barrystaes/Stoommachine-Aircontrol/2017 nette versie/schemas/Print aircontroller.jpg

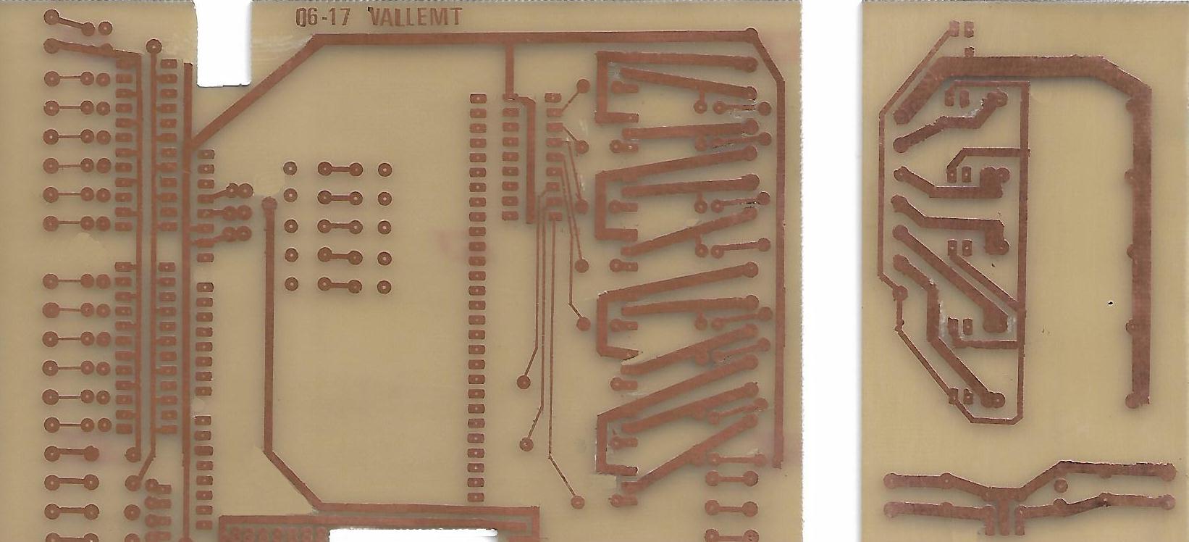
2017 nette versie/schemas/Print aircontroller.jpg
