barrystaes/Stoommachine-Aircontrol/README.md

# Stoommachine aircontrol
Stichting Stoommachine Oisterwijk 
http://destoommachine.nl/

# Licence
ISC
