barrystaes/Stoommachine-Aircontrol/2017 nette versie/tekeningen en schema's/Schema's gebouw/Metingen.docx

Metingen elektrische installatie

Machinekamer datum: 11 maart 2017

Groepnr. | Aardlek type | Uitschak. spanning | Ra in Ohm | Uitschak. stroom | Uitschak. tijd | Opm
1
2
3 | 40/0,03A | 2V | 60 | 22,5 mA | 20m”
4
5
6
7 | 63/0,03A | 2V | 60 | 23,4 mA | 30m”
8
9
10
11 | 40/0,03A | 2V | 60 | 18,7 mA | 20 m”
12
13 | 40/0,03A | 2V | 60 | 22,1 mA | 30m”
14 | C10/0,03A | 2V | 60 | 23,4 mA | 130 m”
15 | B16/0,03A | 2V | 60 | 22,8 mA | 140 m”
K1
K2 | 63/0,3A | 3V | 9 | 196 mA | 40 m”
K3
