barrystaes/Stoommachine-Aircontrol/2017 nette versie/schemas/KVL machinekamer BG_ELst.jpg

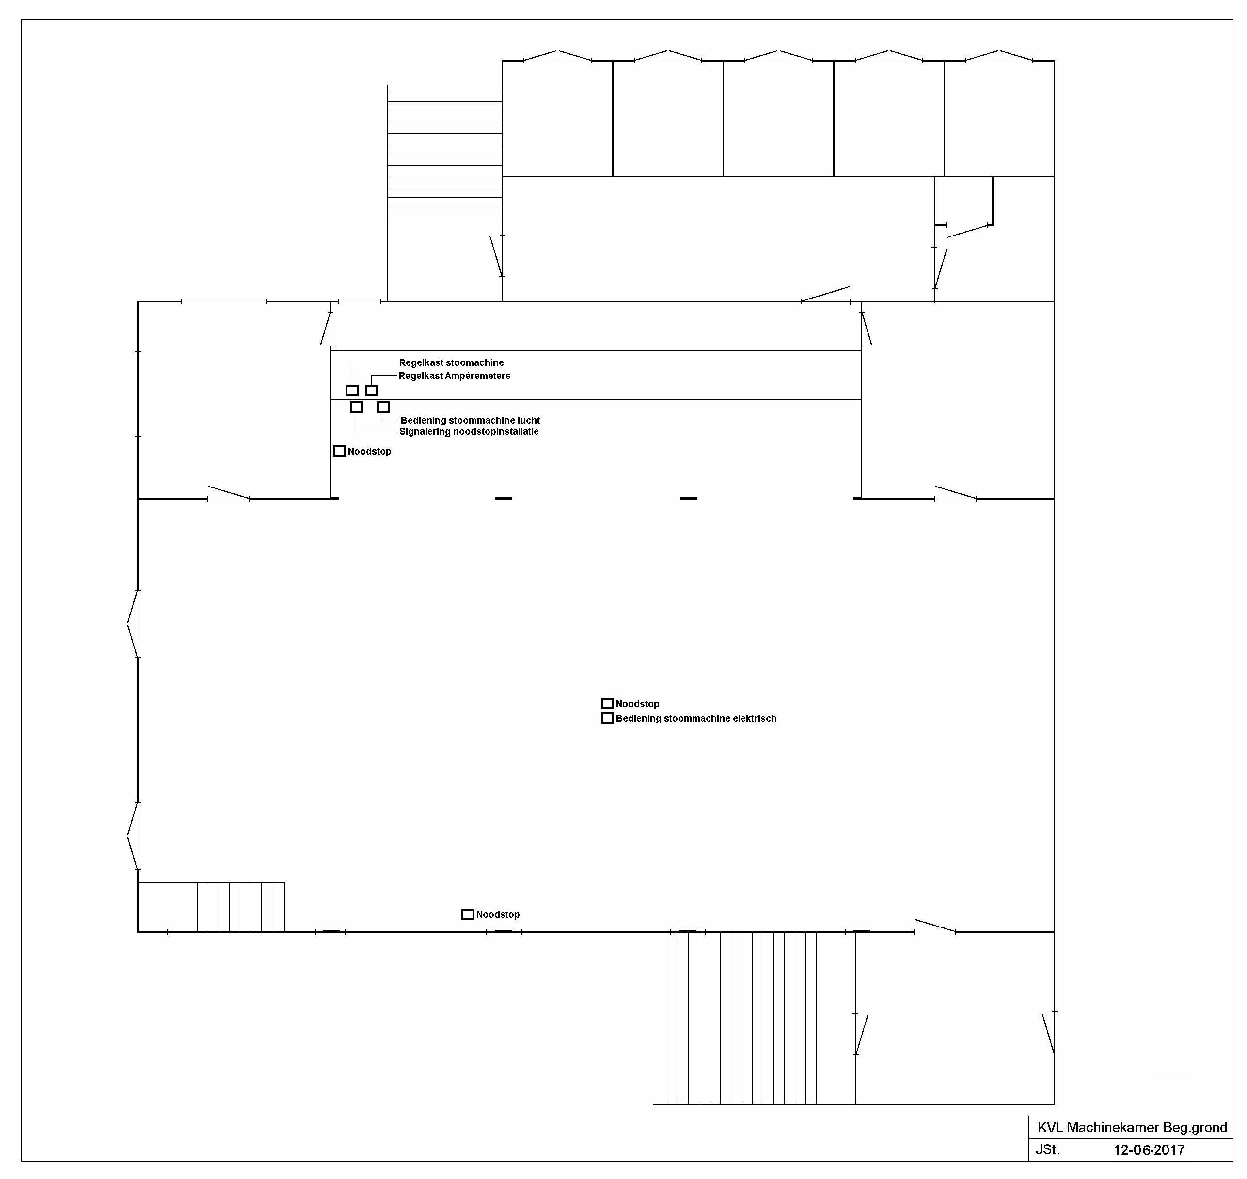
2017 nette versie/schemas/KVL machinekamer BG_ELst.jpg
