barrystaes/Stoommachine-Aircontrol/2017 nette versie/schemas/KVL machinekamer kelder_ELst.jpg

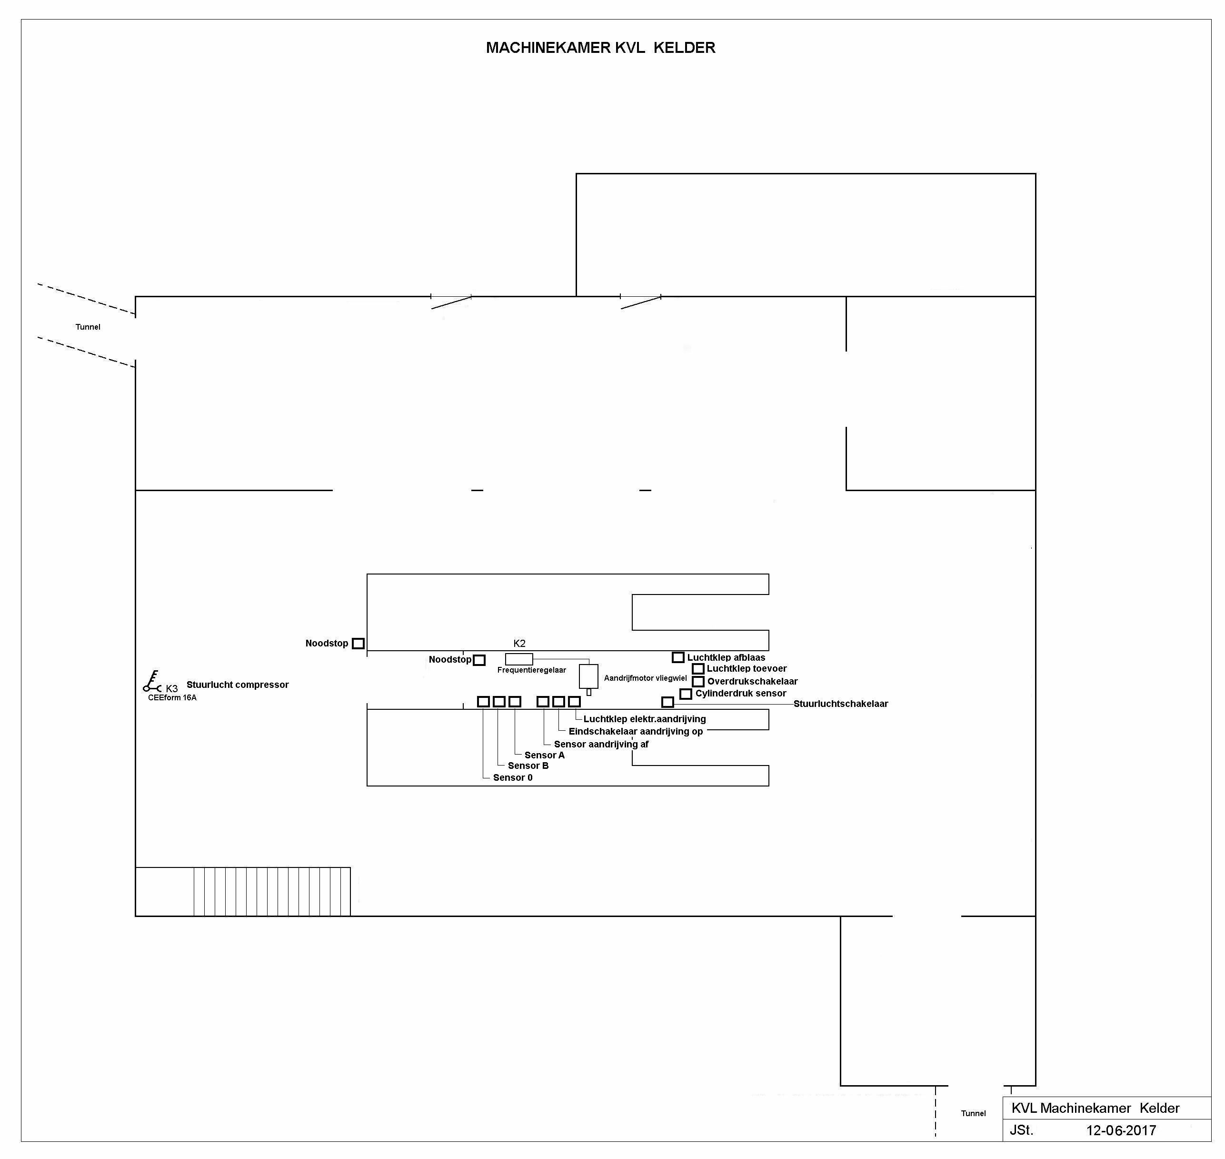
2017 nette versie/schemas/KVL machinekamer kelder_ELst.jpg
