barrystaes/Stoommachine-Aircontrol/2017 nette versie/schemas/Sch_hoofdprint aircontroller.jpg

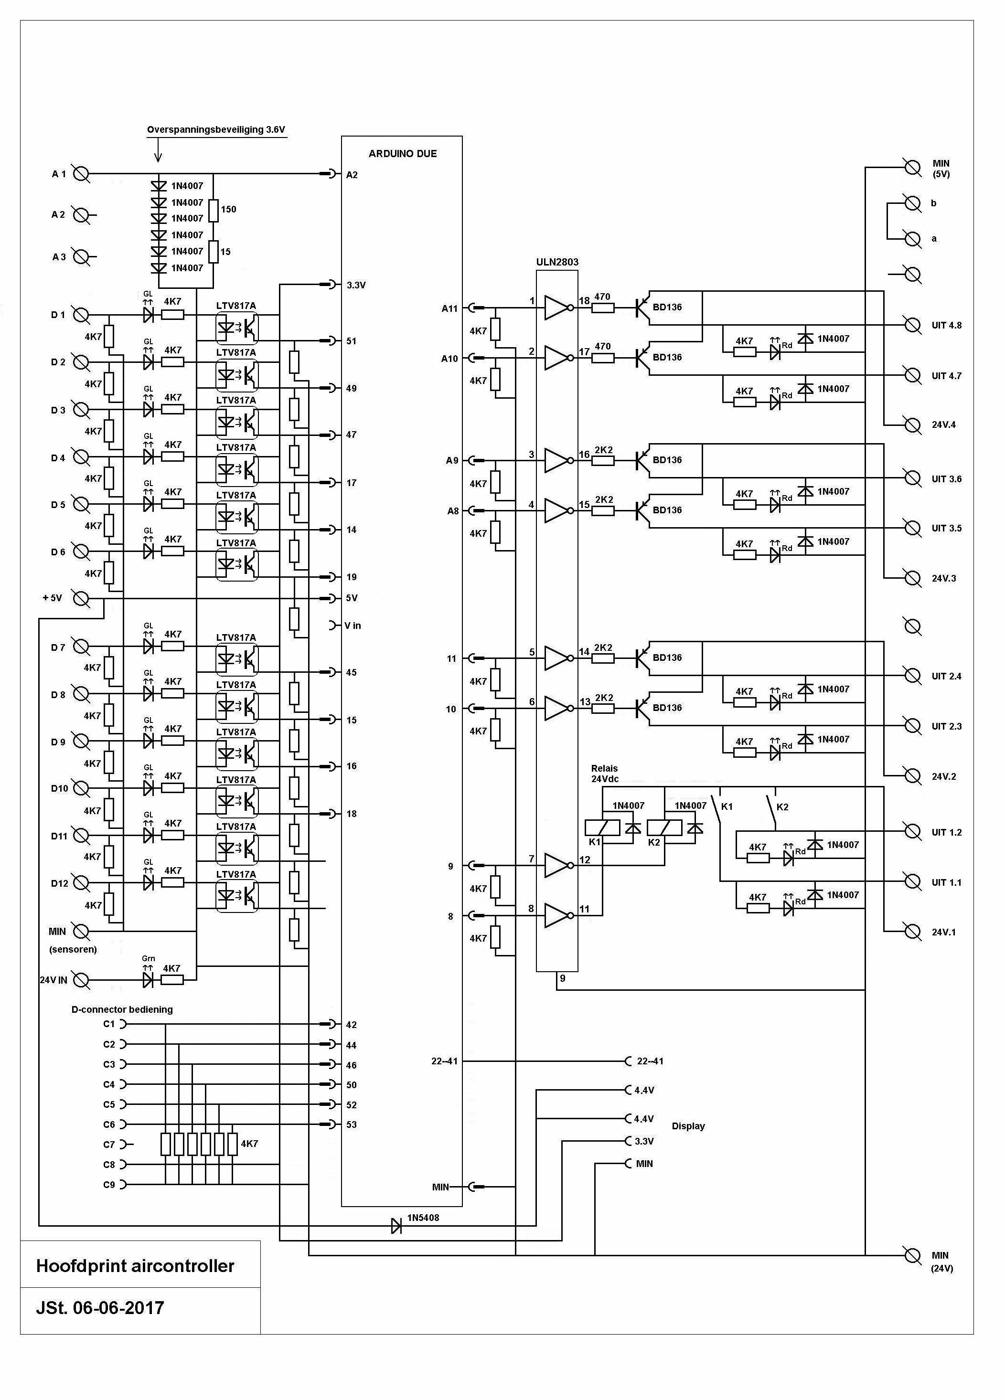
2017 nette versie/schemas/Sch_hoofdprint aircontroller.jpg
