barrystaes/Stoommachine-Aircontrol/2017 nette versie/schemas/Schema frequentieregelaar.jpg

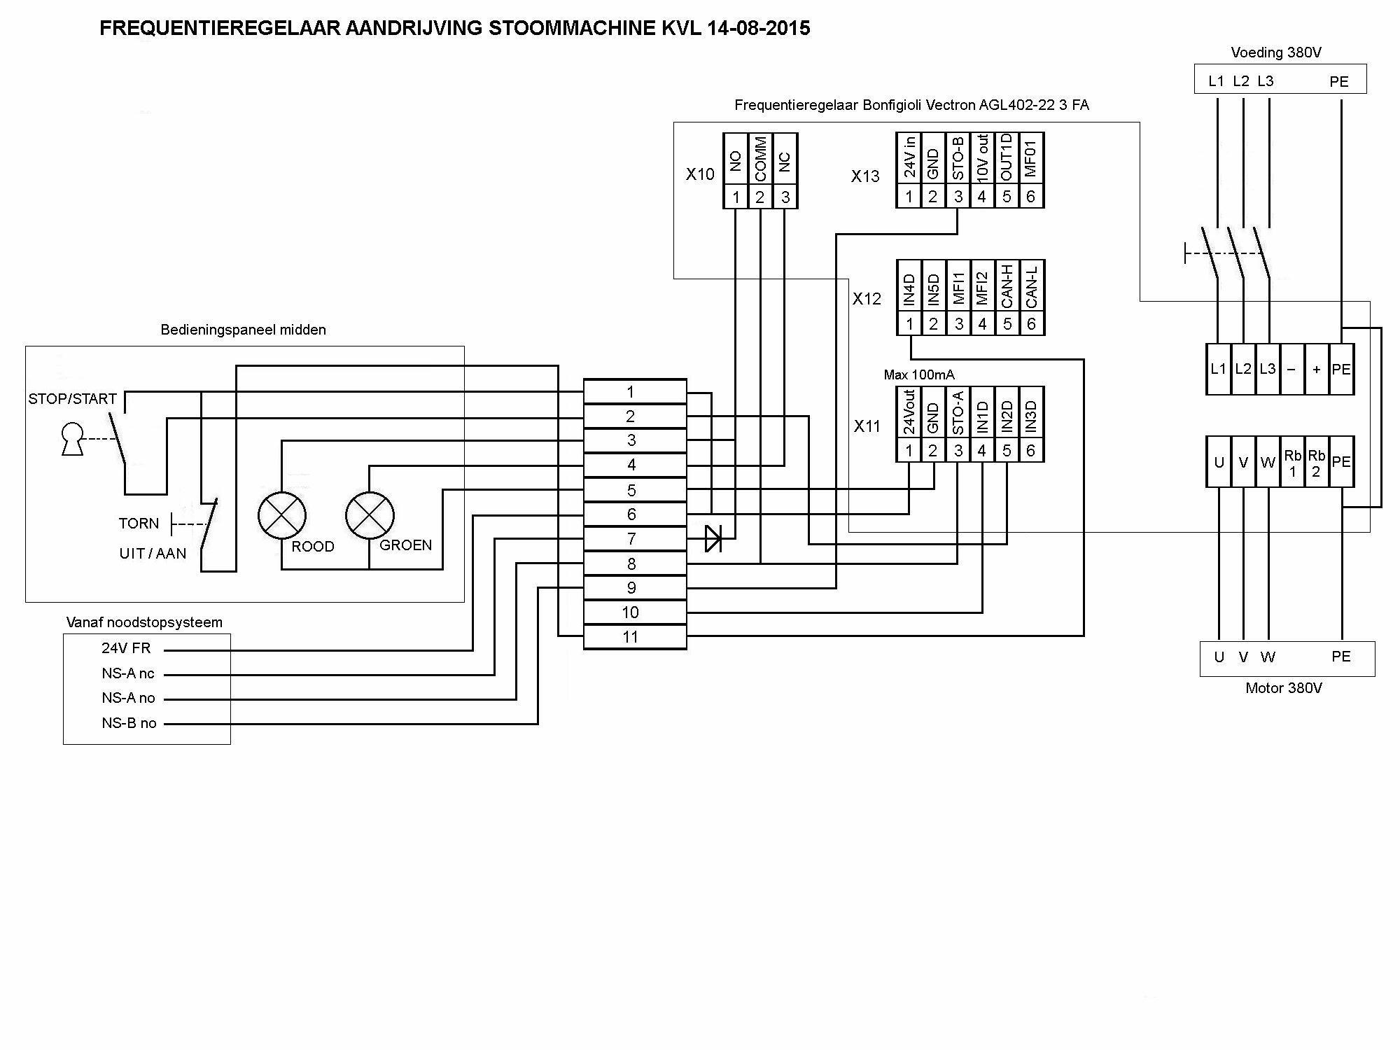
2017 nette versie/schemas/Schema frequentieregelaar.jpg
