barrystaes/Stoommachine-Aircontrol/2017 nette versie/schemas/Schema noodstopsysteem.jpg

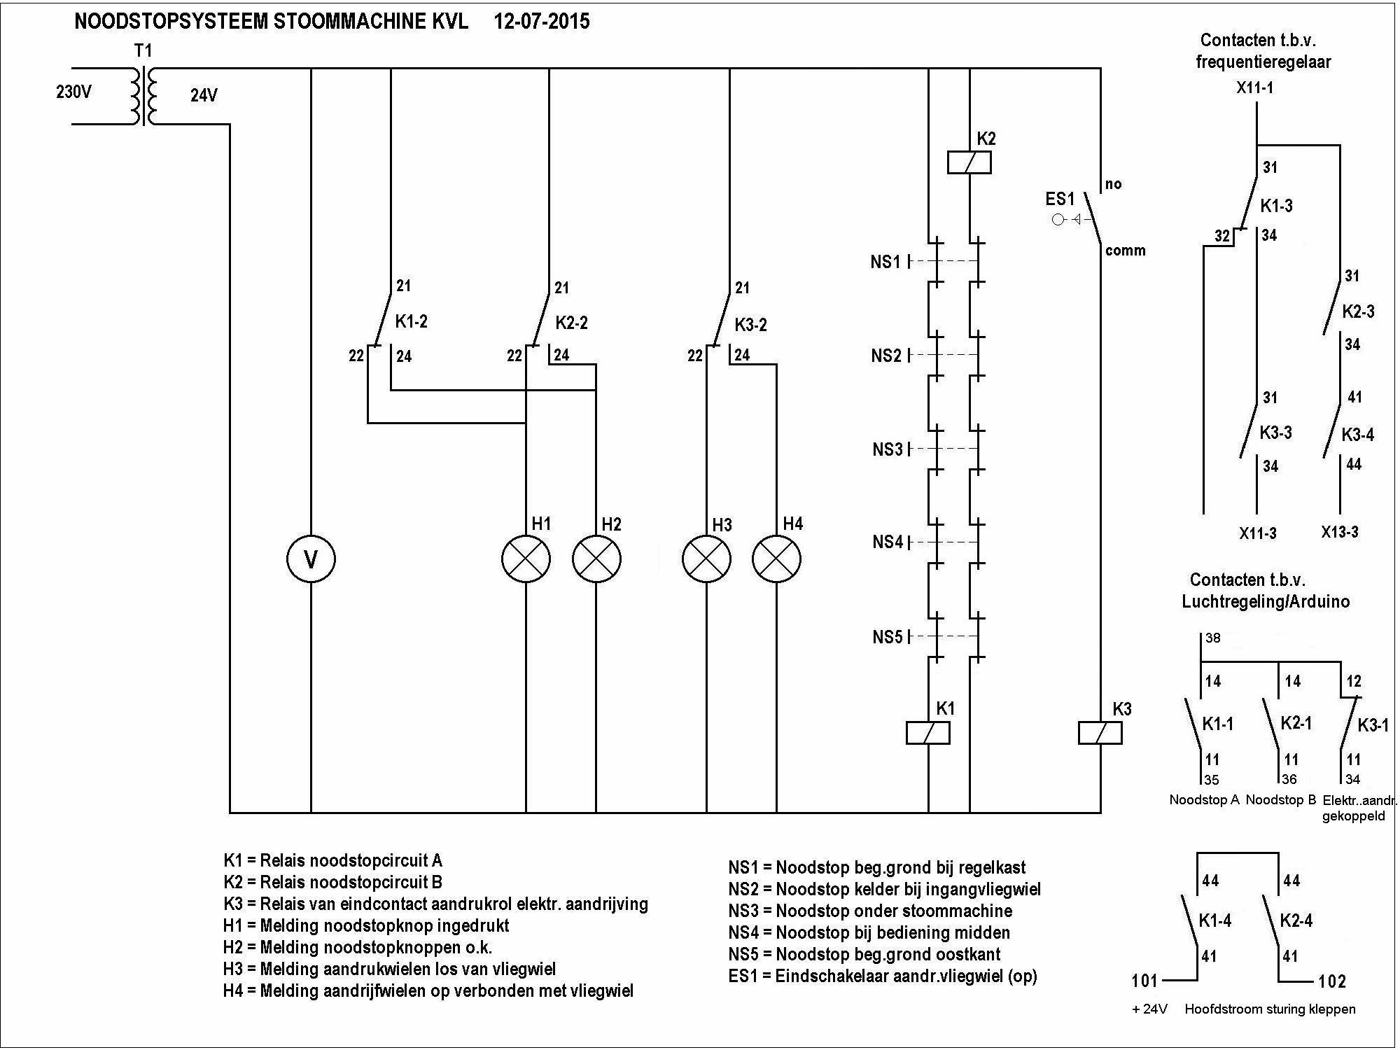
2017 nette versie/schemas/Schema noodstopsysteem.jpg
