barrystaes/Stoommachine-Aircontrol/2017 nette versie/schemas/Totaalschema.jpg

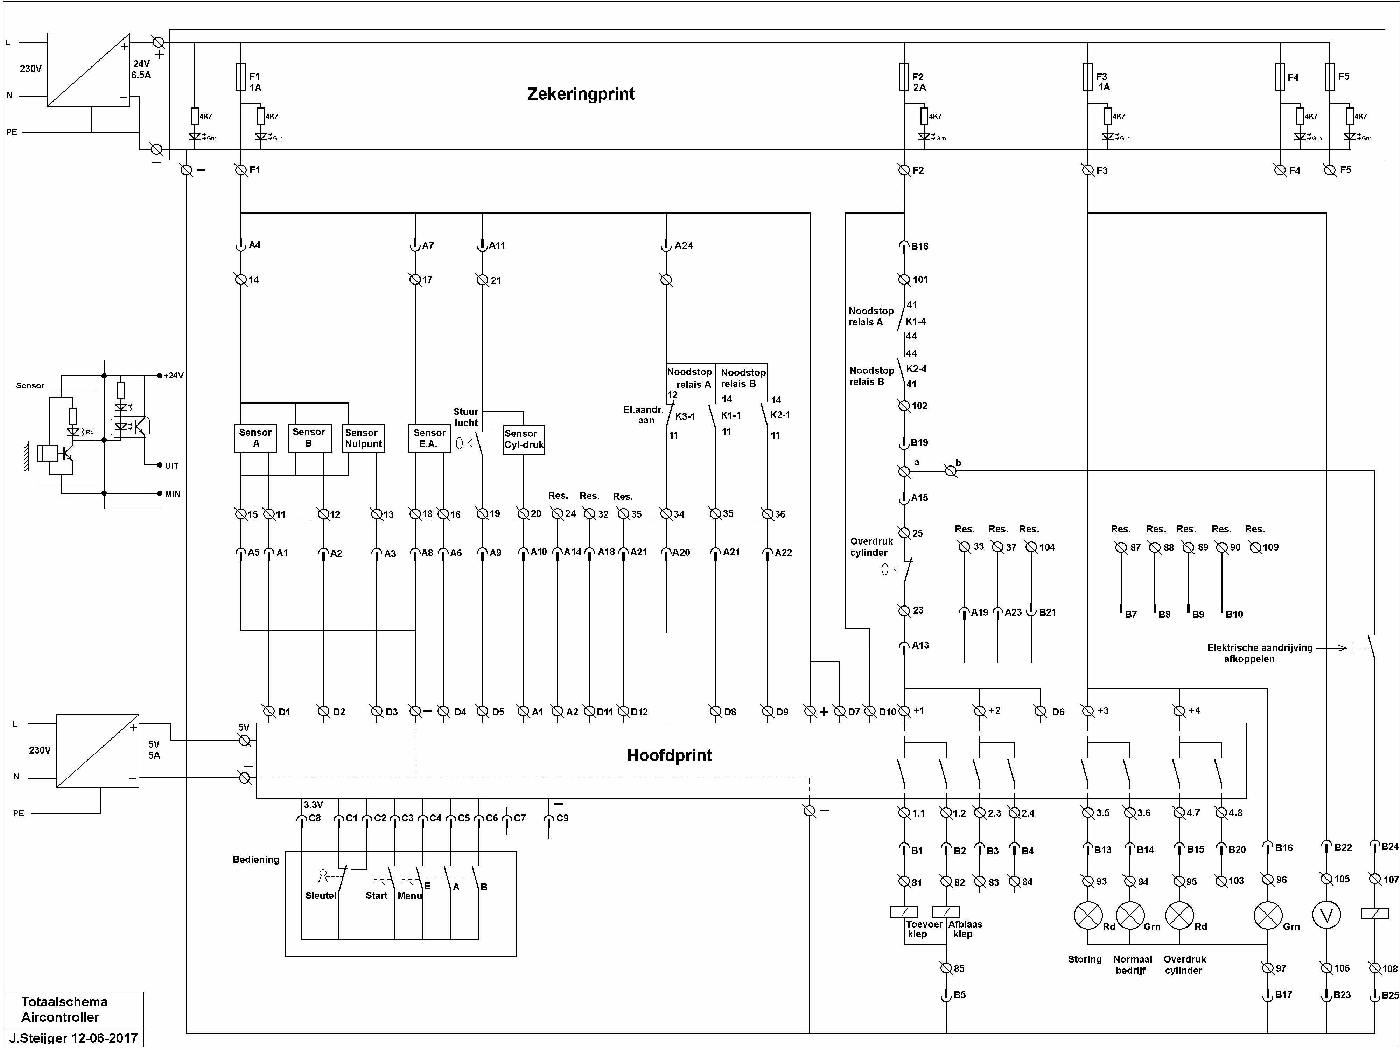
2017 nette versie/schemas/Totaalschema.jpg
