barrystaes/Stoommachine-Aircontrol/2017 nette versie/tekeningen en schema's/Schema's aircontroller/Schema frequentieregelaar.jpg

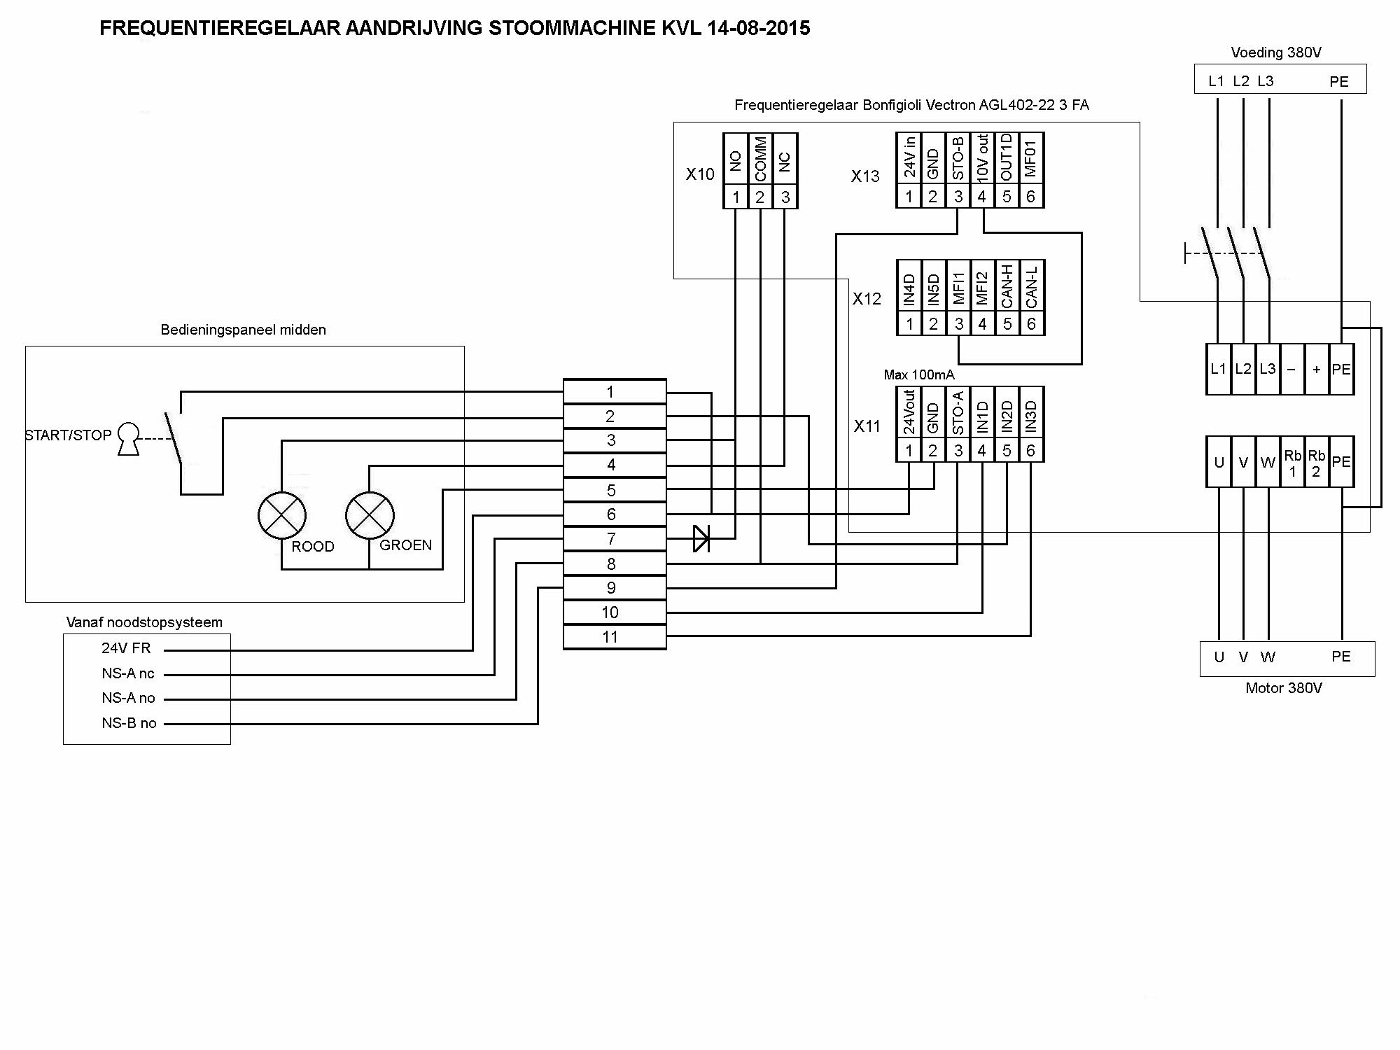
2017 nette versie/tekeningen en schema's/Schema's aircontroller/Schema frequentieregelaar.jpg
