barrystaes/Stoommachine-Aircontrol/2017 nette versie/tekeningen en schema's/Schema's gebouw/KVL machinekamer kelder_EL.jpg

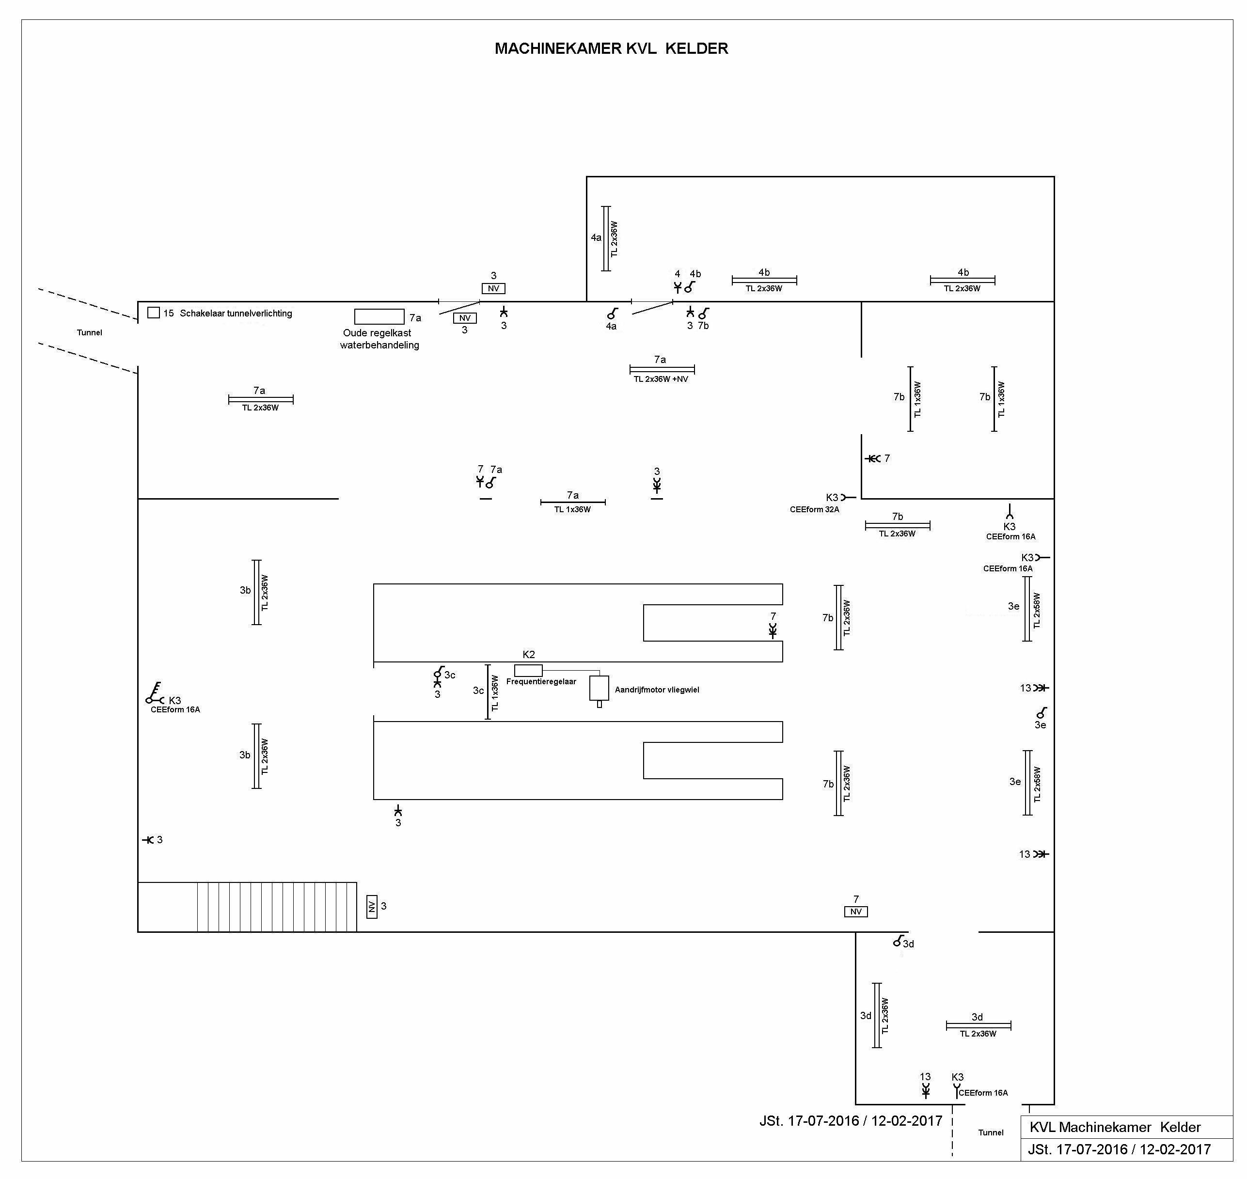
2017 nette versie/tekeningen en schema's/Schema's gebouw/KVL machinekamer kelder_EL.jpg
