barrystaes/Stoommachine-Aircontrol/2017 nette versie/tekeningen en schema's/Schema's gebouw/Schema Verdeelkast en generator.jpg

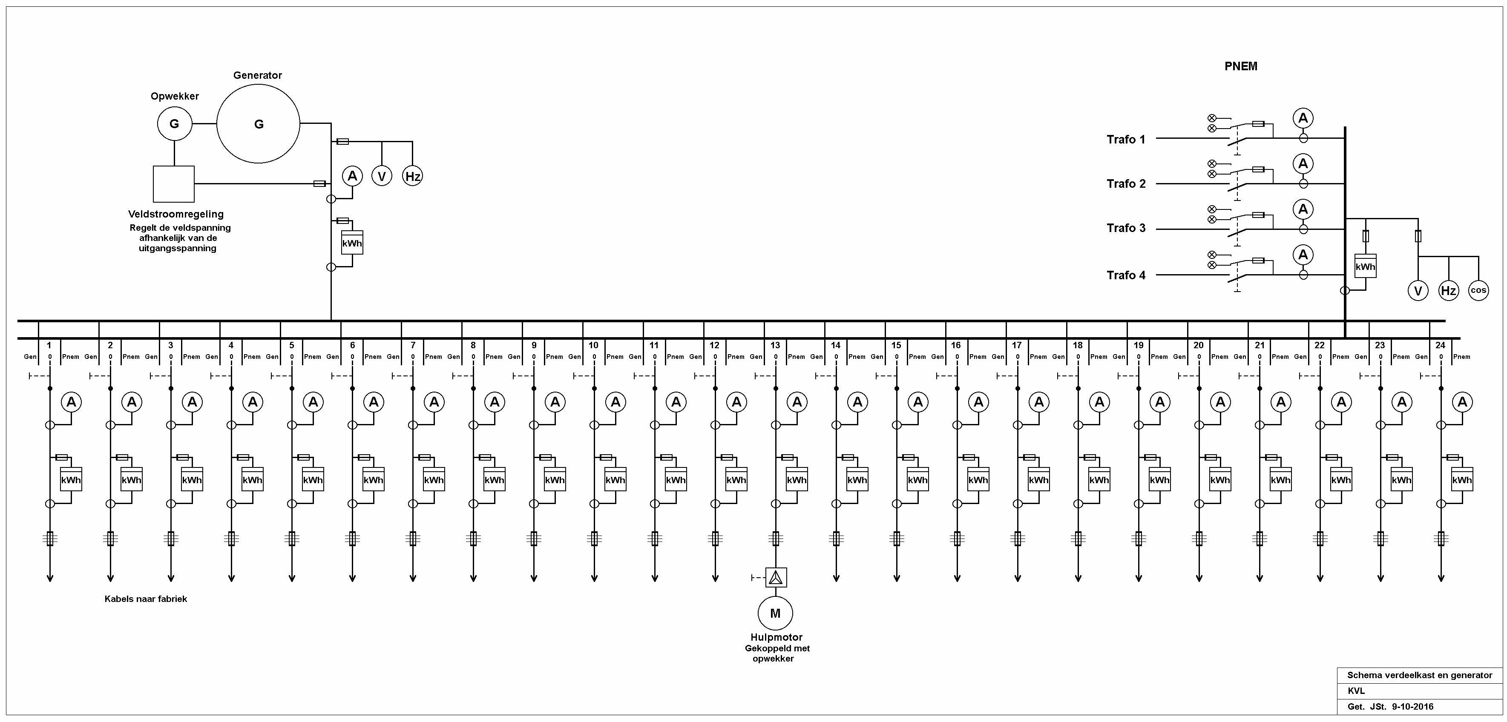
2017 nette versie/tekeningen en schema's/Schema's gebouw/Schema Verdeelkast en generator.jpg
