barrystaes/Stoommachine-Aircontrol/2017 nette versie/tekeningen en schema's/Schema's gebouw/Verdeelkast KVL_LK4.jpg

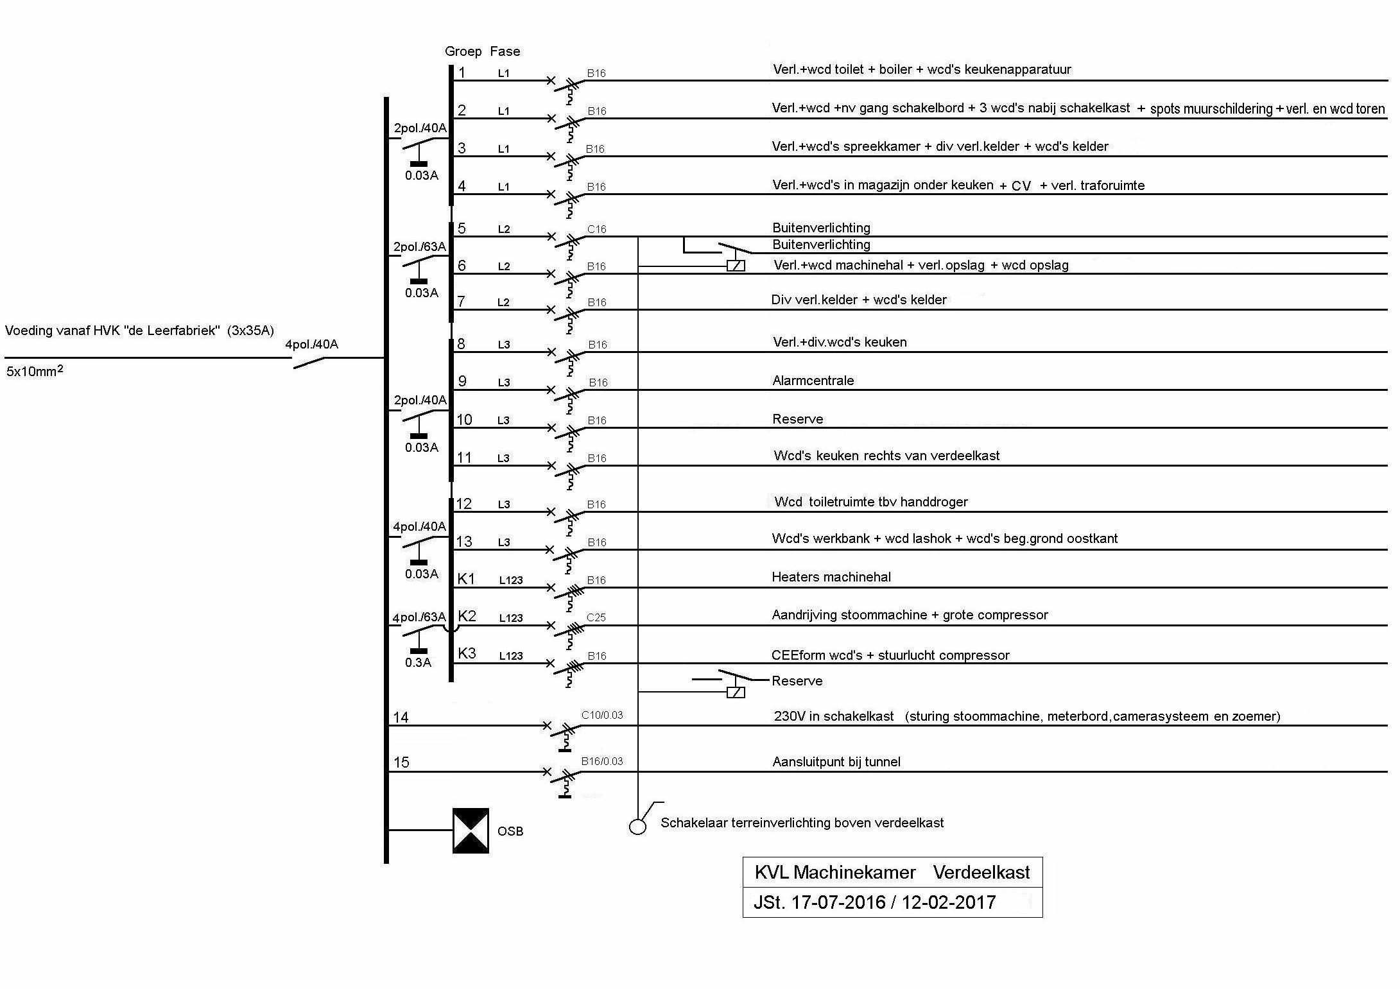
2017 nette versie/tekeningen en schema's/Schema's gebouw/Verdeelkast KVL_LK4.jpg
