barrystaes/Stoommachine-Aircontrol/2017 nette versie/tekeningen en schema's/Schema's gebouw/Voeding machinekamer en compressor.jpg

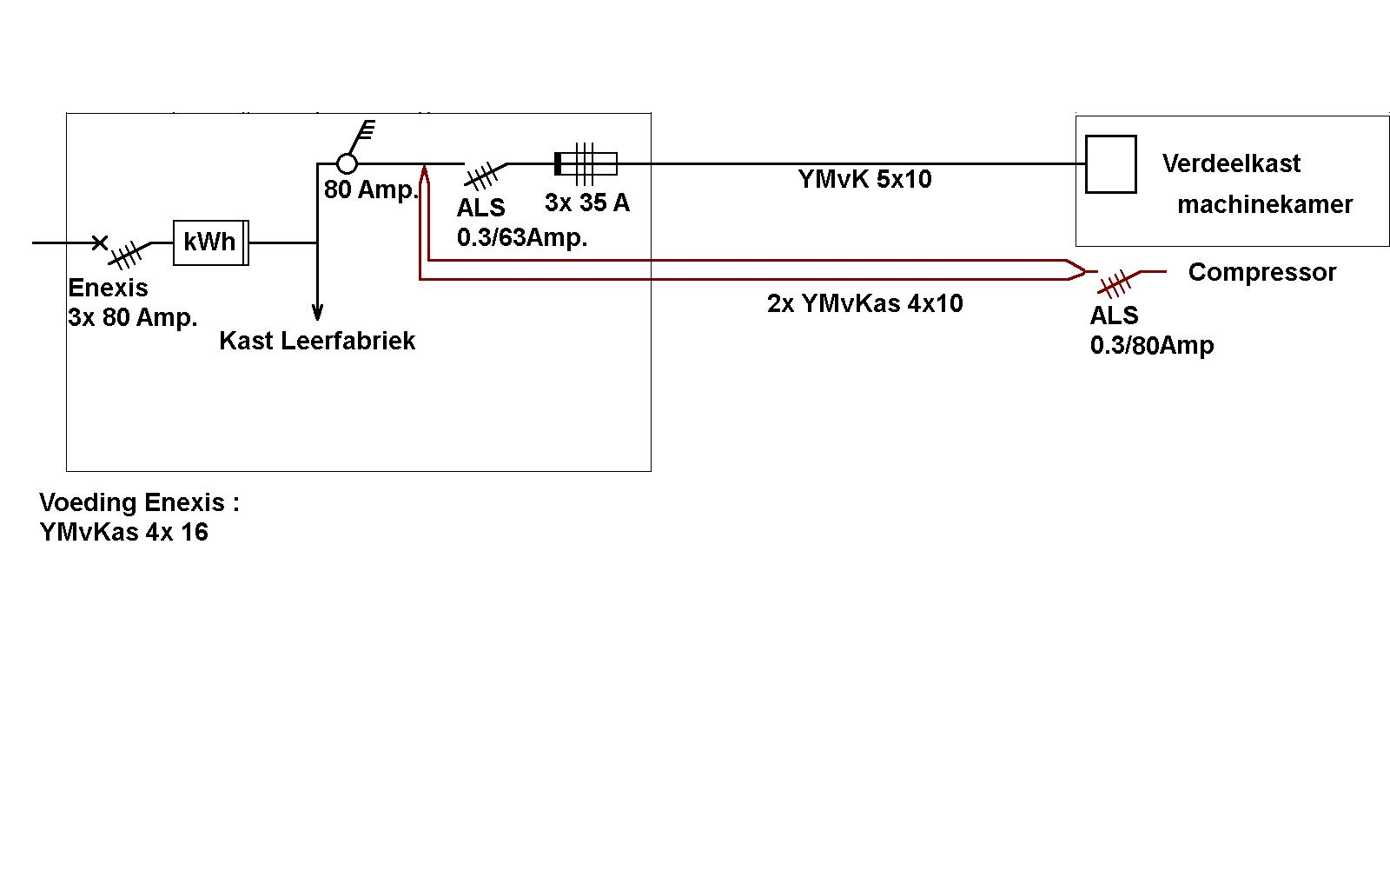
2017 nette versie/tekeningen en schema's/Schema's gebouw/Voeding machinekamer en compressor.jpg
