barrystaes/Stoommachine-Aircontrol/2017 nette versie/schemas/Verloopkabel display.xlsx

Verloopkabel Arduino - TFT display |  |  | 12-02-2017
Ard | Functie | Display | 1 | 2 | 3 | 4 | 5 | 6 | 7 | 8 | 9 | 10 | 11 | 12 | 13 | 14 | 15 | 16 | 17 | 18 | 19 | 20
GND | GND | 1 | 21 | 22 | 23 | 24 | 25 | 26 | 27 | 28 | 29 | 30 | 31 | 32 | 33 | 34 | 35 | 36 | 37 | 38 | 39 | 40
5V | VCC | 2
- | nc. | 3
D40 | RS | 4
D41 | WR | 5
3.3V | RD | 6
D22 | DB8 | 7
D23 | DB9 | 8
D24 | DB10 | 9
D25 | DB11 | 10
D26 | DB12 | 11
D27 | DB13 | 12
D28 | DB14 | 13
D29 | DB15 | 14
D38 | CS | 15
- | F CS | 16
D39 | REST | 17
- | nc. | 18
5V | LED A | 19
- | nc. | 20
D37 | DB0 | 21
D36 | DB1 | 22
D35 | DB2 | 23
D34 | DB3 | 24
D33 | DB4 | 25
D32 | DB5 | 26
D31 | DB6 | 27
D30 | DB7 | 28
Ard | Functie | Display
- | D_CLK | 29
- | D_CS | 30
- | D_DIN | 31
- | D_BUSY | 32
- | D_OUT | 33
- | D_Penirq | 34
- | SD_OUT (F_SI) | 35
- | SD_SCK (F_SCK | 36
- | SD_DIN (F_SO) | 37
- | SD_CS | 38
- | F_WP | 39
- | F_HOLD | 40
