barrystaes/Stoommachine-Aircontrol/Notes/TODO.txt

TODO prototype2:

software:
OK	- Read sensor bits.
OK	- Track machine position (and error flags)
	- Revolution dashboard: Render current position
	- Revolution dashboard: Render revolutions, RPM, error flags.
		
	- Control relays based on machine position
	- Revolution dashboard: Render relay timing 

	- Read pressure sensor.
	- Revolution dashboard: Render pressure sensor.

	- Menu: dummy RPM target

hardware:
wip	- Read pressure sensor (analog 20mA loop) proof of concept.
	- Menu button breakout
	- Buzzer for menu feedback
	- LED WS2812B proof of concept
	- Output machine position to PC
	- Relay manual override dipswitches
	- Connect SD-card for logging (and while at it try reading bitmaps with utft_tinyfat)

TODO prototype3

OK	- Consider reading sensors via port. (all at once)
n	- Consider setting valves via port. (all at once)

LINKS on design

Quadratic Encoder (machine positie sensor, en menuknop)
https://hifiduino.wordpress.com/2010/10/20/rotaryencoder-hw-sw-no-debounce/  effecient read
http://en.wikipedia.org/wiki/Gray_code

Pin ports
http://forum.arduino.cc/index.php?topic=260731.0
http://www.arduino.cc/en/Hacking/PinMappingSAM3X

Speaker (op een DUE)
