barrystaes/Stoommachine-Aircontrol/2017 nette versie/software/aircontrol/changelog.txt

Changelog
===========
2017-06-14 Barry-John: kopie van GitHub naar Dropbox "2017 nette versie".
2017-06-14 Barry: nieuwe in-outputs
2017-06-15 John: werkende encoders
2017-06-18 John: menuknop debug
2017-06-19 John+Barry: geinverteerde nul en elektrische aandrijfing
2018-02-03 John: inverteren nulsensor
2021-10-20 Bas+Barry+John: nieuwe klep timing, finetune op gehoor
2022-05-21 Barry: Start reset de zero-sensor errors, workaround voor open dag.
