barrystaes/Stoommachine-Aircontrol/Prototype1/hardware-tests/kleppen.brd

## EAGLE design Prototype1/hardware-tests/kleppen.brd (2015-03-01, an earlier design)

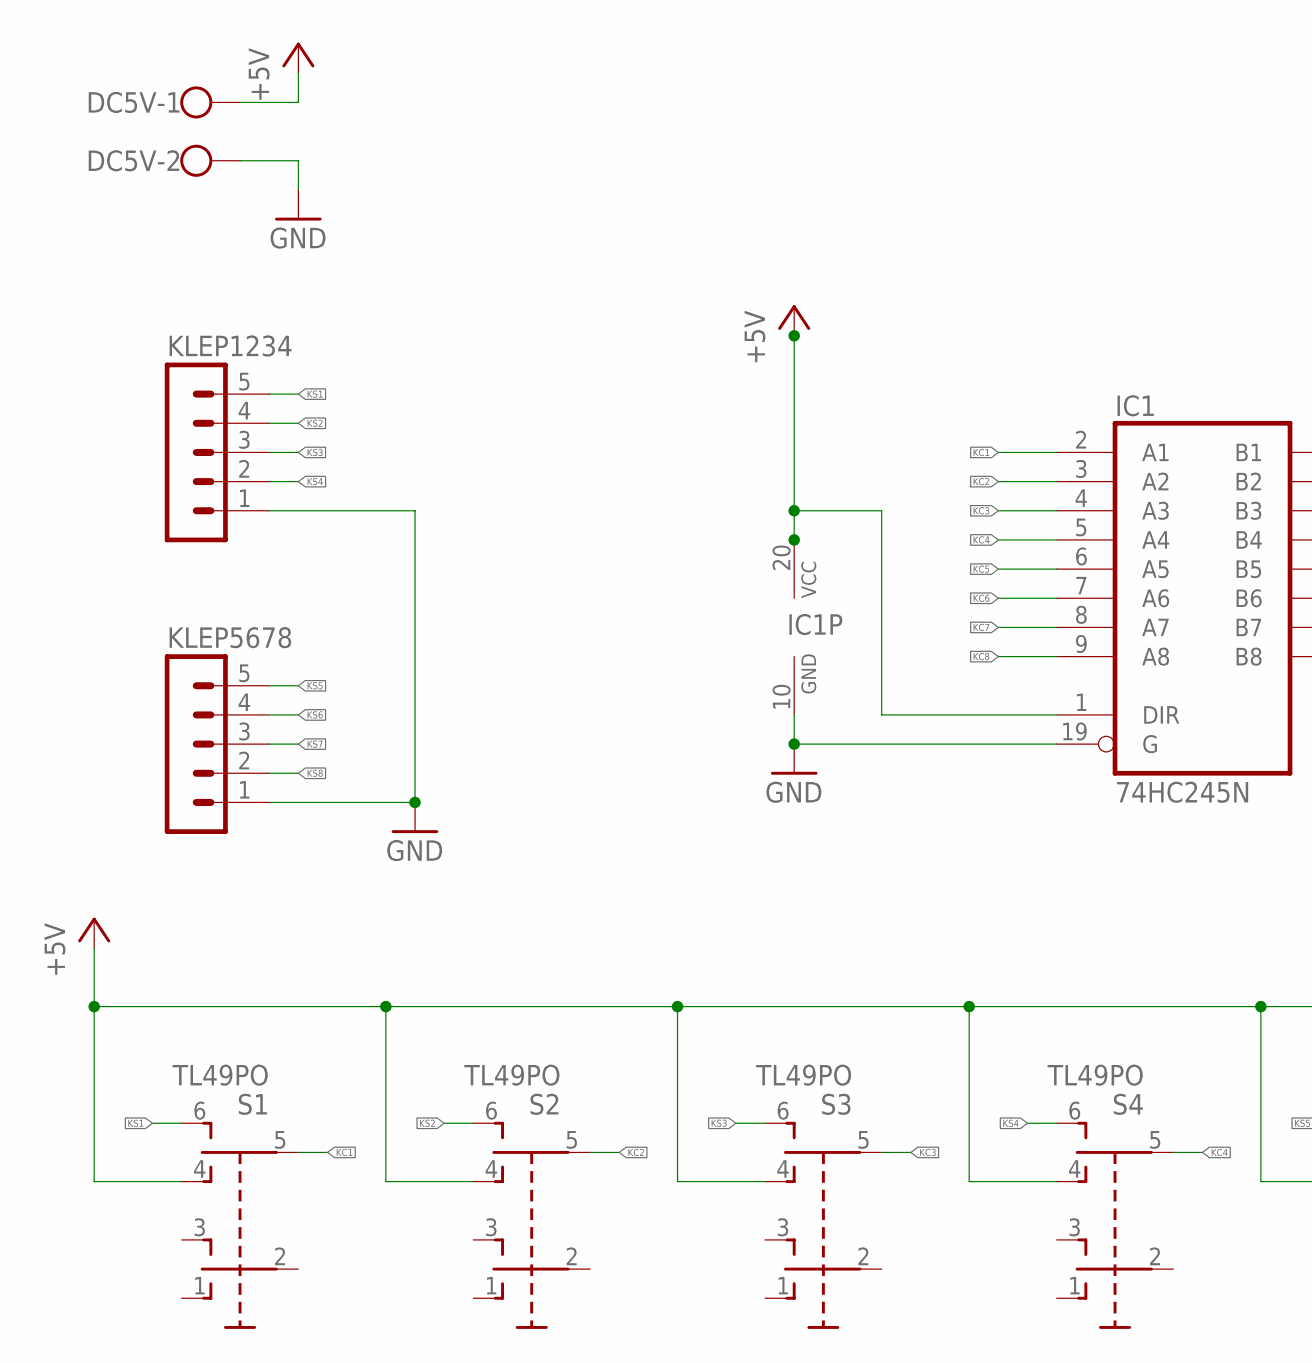
[picture p16: schematic kleppen.sch, part in row 1, column 1]

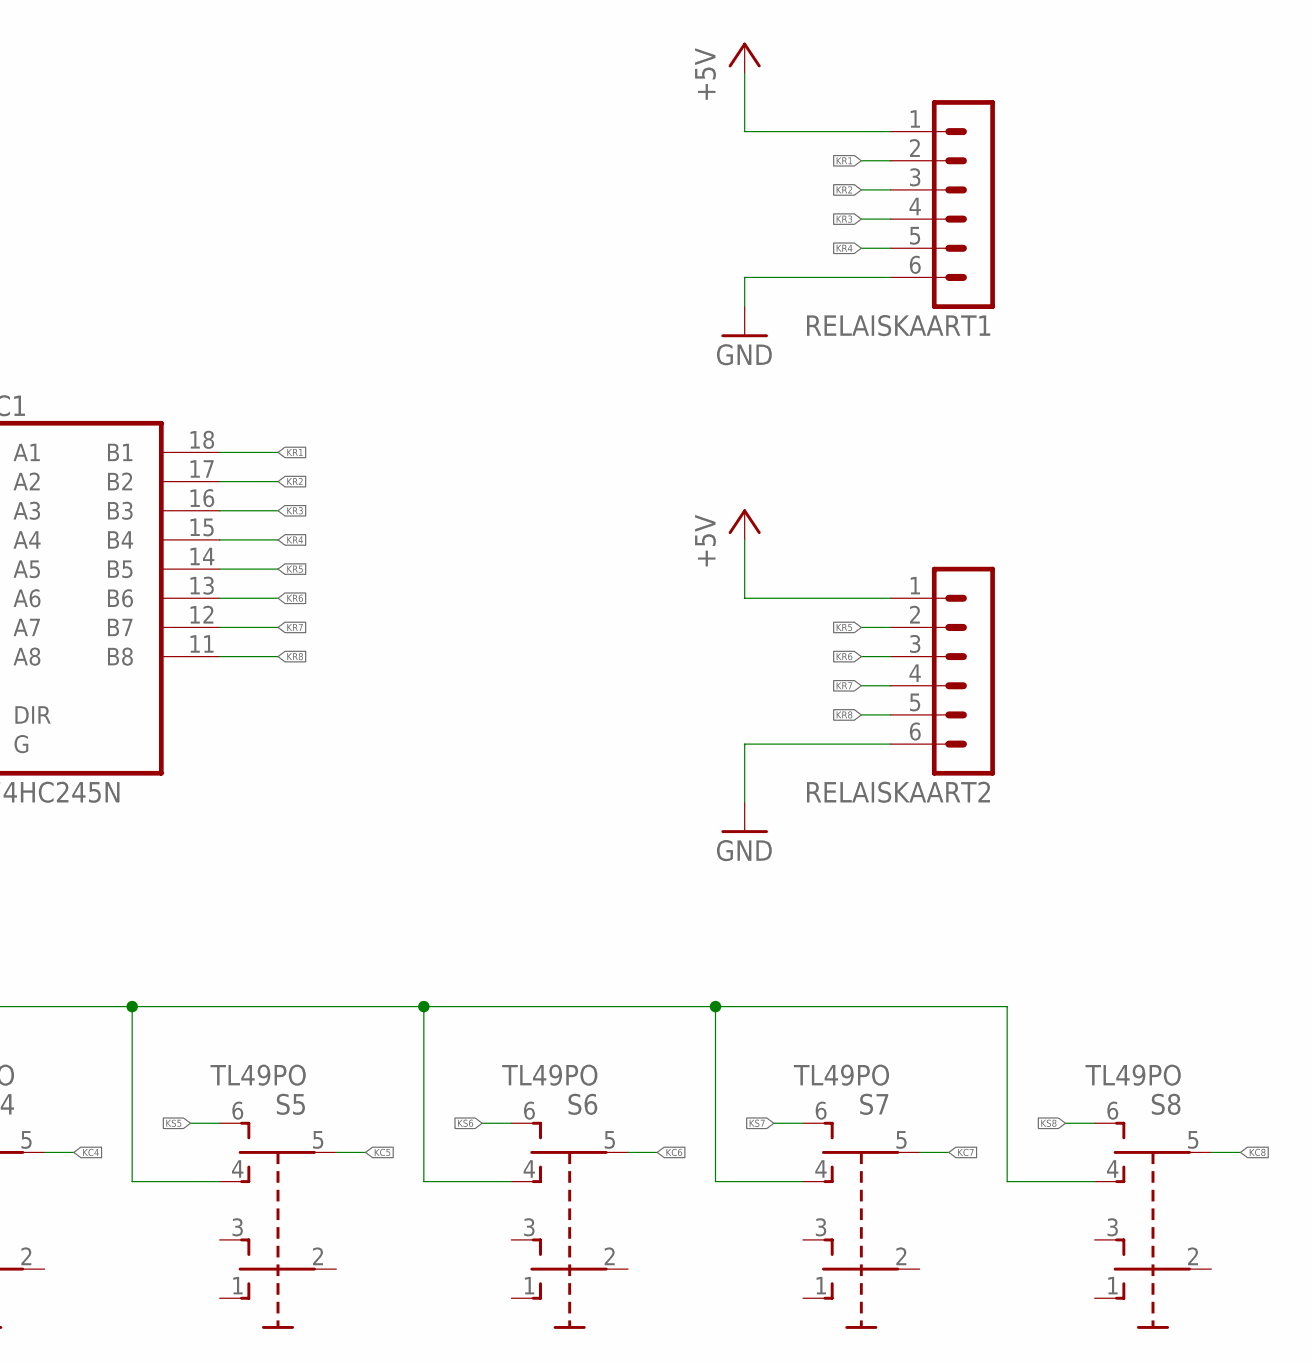
[picture p17: schematic kleppen.sch, part in row 1, column 2]

Parts:
DC5V: W237-102
IC1: 74HC245N; DIL20
KLEP1234, KLEP5678: MA05-1
RELAISKAART1, RELAISKAART2: MA06-1
S1, S2, S3, S4, S5, S6, S7, S8: TL49PO; TL4XPO

Connections:
+5V: DC5V.1, IC1.1 (DIR), IC1.20 (VCC), RELAISKAART1.1, RELAISKAART2.1, S1.4 (O1), S2.4 (O1), S3.4 (O1), S4.4 (O1), S5.4 (O1), S6.4 (O1), S7.4 (O1), S8.4 (O1)
GND: DC5V.2, IC1.10 (GND), IC1.19 (G), RELAISKAART1.6, RELAISKAART2.6
KC1: IC1.2 (A1), S1.5 (P1)
KC2: IC1.3 (A2), S2.5 (P1)
KC3: IC1.4 (A3), S3.5 (P1)
KC4: IC1.5 (A4), S4.5 (P1)
KC5: IC1.6 (A5), S5.5 (P1)
KC6: IC1.7 (A6), S6.5 (P1)
KC7: IC1.8 (A7), S7.5 (P1)
KC8: IC1.9 (A8), S8.5 (P1)
KR1: IC1.18 (B1), RELAISKAART1.2
KR2: IC1.17 (B2), RELAISKAART1.3
KR3: IC1.16 (B3), RELAISKAART1.4
KR4: IC1.15 (B4), RELAISKAART1.5
KR5: IC1.14 (B5), RELAISKAART2.2
KR6: IC1.13 (B6), RELAISKAART2.3
KR7: IC1.12 (B7), RELAISKAART2.4
KR8: IC1.11 (B8), RELAISKAART2.5
KS1: KLEP1234.5, S1.6 (S1)
KS2: KLEP1234.4, S2.6 (S1)
KS3: KLEP1234.3, S3.6 (S1)
KS4: KLEP1234.2, S4.6 (S1)
KS5: KLEP5678.5, S5.6 (S1)
KS6: KLEP5678.4, S6.6 (S1)
KS7: KLEP5678.3, S7.6 (S1)
KS8: KLEP1234.1, KLEP5678.1, KLEP5678.2, S8.6 (S1)

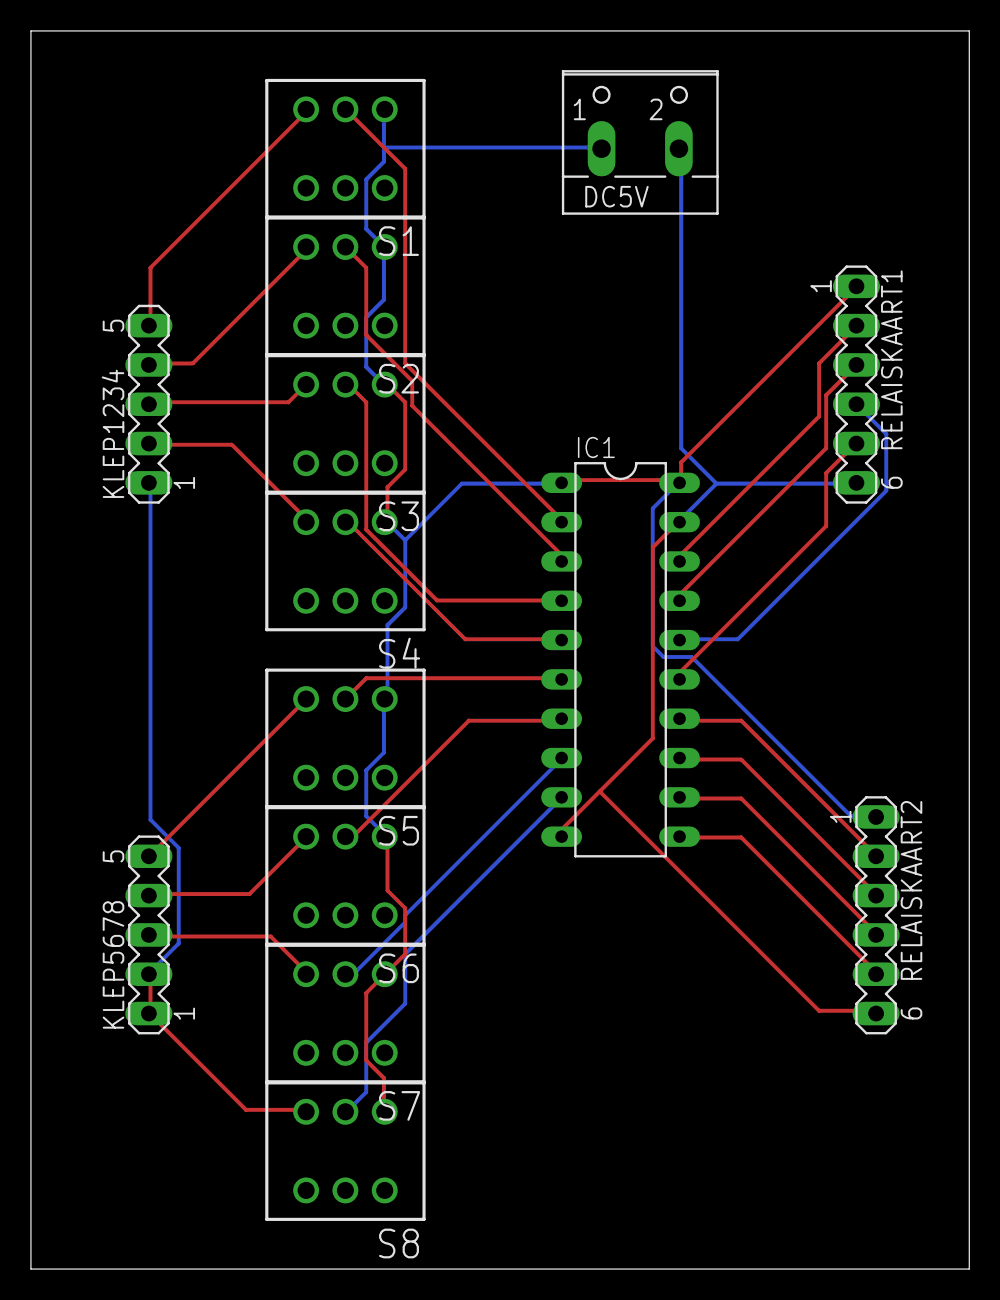
[picture p18: board kleppen.brd from above]

Board: 2 copper layers, 60.6 x 80.0 mm, 14 parts (0 on the bottom side), 26 nets.
