barrystaes/Stoommachine-Aircontrol/Prototype2/hardware/prototype2.brd

## EAGLE design Prototype2/hardware/prototype2.brd (2015-06-07)

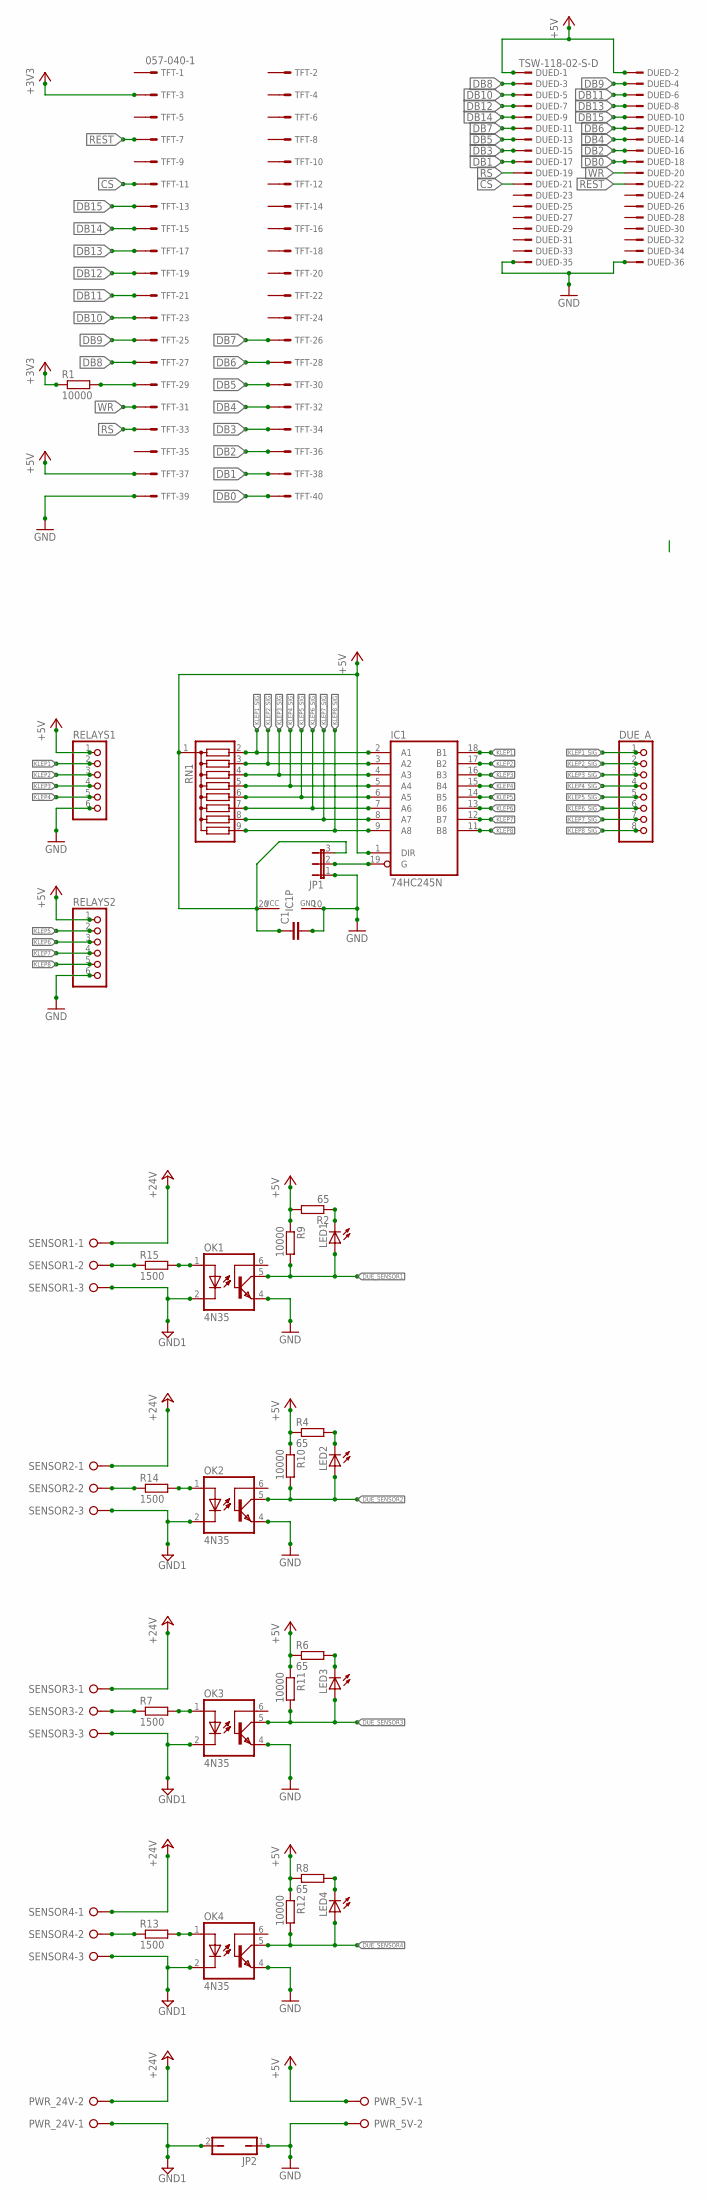
[picture p19: schematic prototype2.sch]

Parts:
C1: C-EU025-024X044; C025-024X044
DUED: TSW-118-02-S-D
DUE_A: PINHD-1X8; 1X08
IC1: 74HC245N; DIL20
JP1: JP2E; JP2
JP2: JP1Q; JP1
LED1, LED2, LED3, LED4: LED5MM
OK1, OK2, OK3, OK4: 4N35; DIL06
PWR_5V, PWR_24V: W237-02P; W237-132
R1, R9, R10, R11, R12: 10000; 0204/5
R2, R4, R6, R8: 65; 0204/5
R7, R13, R14, R15: 1500; 0204/5
RELAYS1, RELAYS2: PINHD-1X6; 1X06
RN1: G08R; SIL9
SENSOR1, SENSOR2, SENSOR3, SENSOR4: W237-03P; W237-133
TFT: 057-040-1

Connections:
+3V3: R1.1, TFT.3
+5V: C1.1, DUED.1, DUED.2, IC1.1 (DIR), IC1.20 (VCC), JP1.3, PWR_5V.1, R2.2, R4.1, R6.1, R8.1, R9.1, R10.1, R11.1, R12.1, RELAYS1.1, RELAYS2.1, RN1.1, TFT.37
+24V: PWR_24V.2, SENSOR1.1, SENSOR2.1, SENSOR3.1, SENSOR4.1
CS: DUED.21, TFT.11
DB0: DUED.18, TFT.40
DB1: DUED.17, TFT.38
DB2: DUED.16, TFT.36
DB3: DUED.15, TFT.34
DB4: DUED.14, TFT.32
DB5: DUED.13, TFT.30
DB6: DUED.12, TFT.28
DB7: DUED.11, TFT.26
DB8: DUED.3, TFT.27
DB9: DUED.4, TFT.25
DB10: DUED.5, TFT.23
DB11: DUED.6, TFT.21
DB12: DUED.7, TFT.19
DB13: DUED.8, TFT.17
DB14: DUED.9, TFT.15
DB15: DUED.10, TFT.13
DUE_SENSOR1: LED1.A, OK1.5 (COL), R9.2
DUE_SENSOR2: LED2.A, OK2.5 (COL), R10.2
DUE_SENSOR3: LED3.A, OK3.5 (COL), R11.2
DUE_SENSOR4: LED4.A, OK4.5 (COL), R12.2
GND: C1.2, DUED.35, DUED.36, IC1.10 (GND), JP1.1, JP2.1, OK1.4 (EMI), OK2.4 (EMI), OK3.4 (EMI), OK4.4 (EMI), PWR_5V.2, RELAYS1.6, RELAYS2.6, TFT.39
GND1: JP2.2, OK1.2 (C), OK2.2 (C), OK3.2 (C), OK4.2 (C), PWR_24V.1, SENSOR1.3, SENSOR2.3, SENSOR3.3, SENSOR4.3
KLEP1: IC1.18 (B1), RELAYS1.2
KLEP1_SIG: DUE_A.1, IC1.2 (A1), RN1.2
KLEP2: IC1.17 (B2), RELAYS1.3
KLEP2_SIG: DUE_A.2, IC1.3 (A2), RN1.3
KLEP3: IC1.16 (B3), RELAYS1.4
KLEP3_SIG: DUE_A.3, IC1.4 (A3), RN1.4
KLEP4: IC1.15 (B4), RELAYS1.5
KLEP4_SIG: DUE_A.4, IC1.5 (A4), RN1.5
KLEP5: IC1.14 (B5), RELAYS2.2
KLEP5_SIG: DUE_A.5, IC1.6 (A5), RN1.6
KLEP6: IC1.13 (B6), RELAYS2.3
KLEP6_SIG: DUE_A.6, IC1.7 (A6), RN1.7
KLEP7: IC1.12 (B7), RELAYS2.4
KLEP7_SIG: DUE_A.7, IC1.8 (A7), RN1.8
KLEP8: IC1.11 (B8), RELAYS2.5
KLEP8_SIG: DUE_A.8, IC1.9 (A8), RN1.9
unnamed: IC1.19 (G), JP1.2
unnamed: R1.2, TFT.29
unnamed: R15.1, SENSOR1.2
unnamed: OK1.1 (A), R15.2
unnamed: LED1.K (C), R2.1
unnamed: OK2.1 (A), R14.2
unnamed: R14.1, SENSOR2.2
unnamed: LED2.K (C), R4.2
unnamed: OK3.1 (A), R7.2
unnamed: R7.1, SENSOR3.2
unnamed: LED3.K (C), R6.2
unnamed: OK4.1 (A), R13.2
unnamed: R13.1, SENSOR4.2
unnamed: LED4.K (C), R8.2
REST: DUED.22, TFT.7
RS: DUED.19, TFT.33
WR: DUED.20, TFT.31

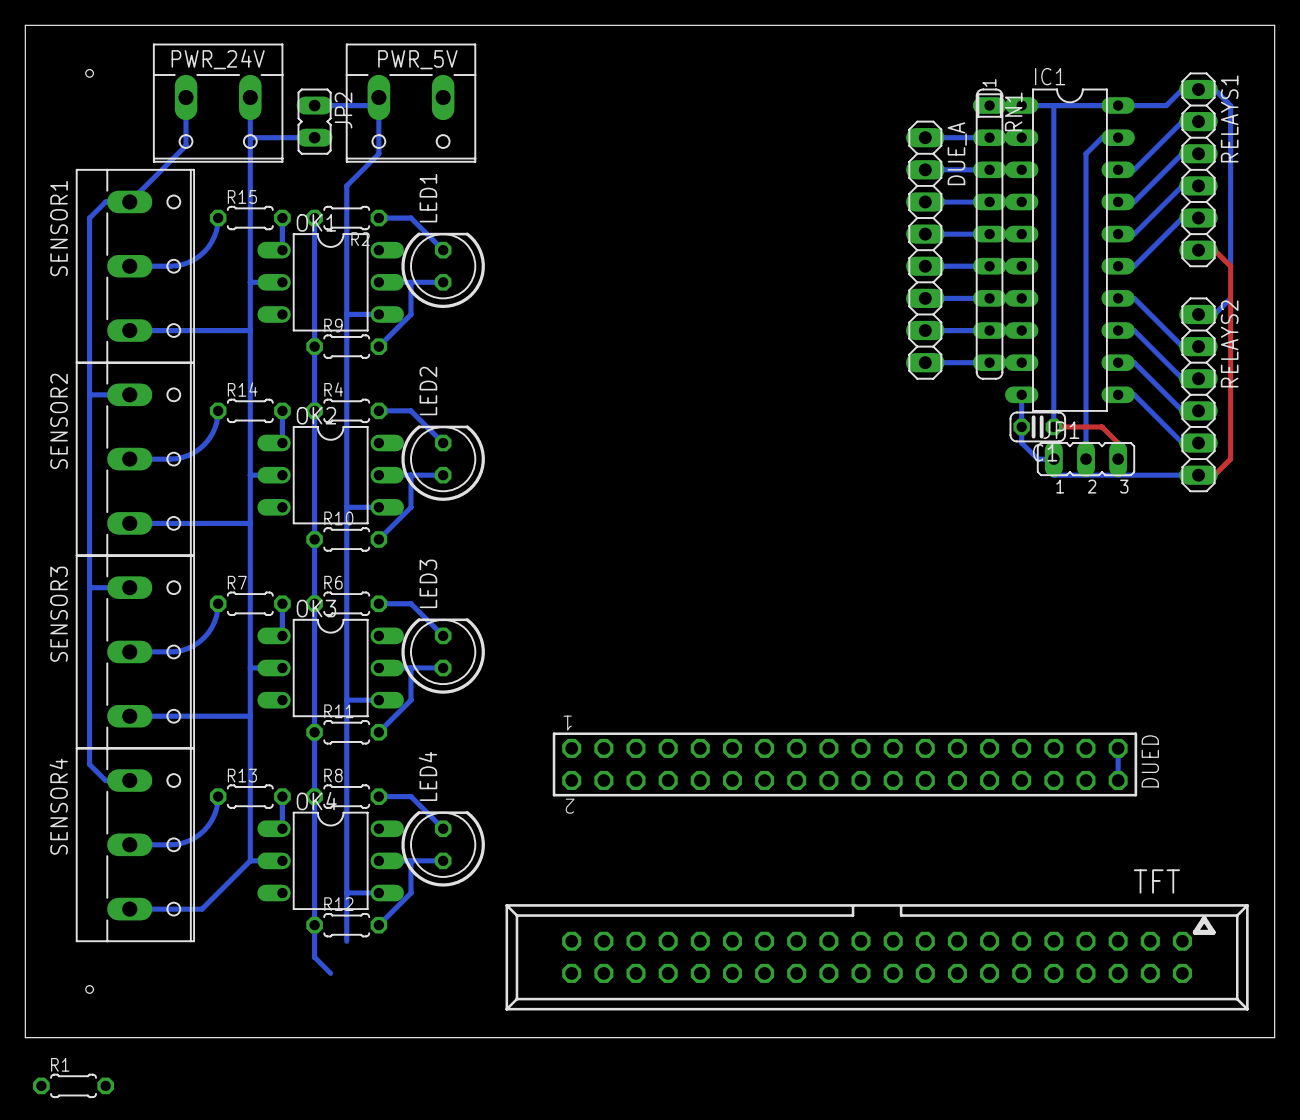
[picture p20: board prototype2.brd from above]

Board: 2 copper layers, 98.7 x 80.0 mm, 37 parts (0 on the bottom side), 59 nets.
