barrystaes/Stoommachine-Aircontrol/(commit log)

2015-02-08 Fix lcd shield test
    [lcd_shield_test.ino]
2015-02-18 Added timer-interrupt counter to lcd shield test (also serial but commented)
2015-03-01 Initial Eagle files (schema dummy test, todo pcb)
    [kleppen.brd, kleppen.sch]
2015-03-05 PCB schema test 4klep.
    [sac_4klep.sch]
2015-03-26 Added UTFT demo for Arduino Due with SSD1289 tft.
2015-04-01 Changed timer-interrupt counter test to support Arduino Due + UTFT
2015-04-02 Added relay test for Arduino Due.
2015-04-02 Extended relay test for Arduino Due.
2015-04-02 Added combined test for Arduino Due.
2015-04-13 Hardware test: eagle file with TFT-Due connectors
    [stoomshield1.sch]
2015-04-14 Hardware test: eagle file with TFT-Due connectors + relay buffer
    [stoomshield1.sch]
2015-04-15 Added sensor readout to combined test.
2015-04-15 Hardware test: eagle file with TFT-Due connectors + relay buffer + sensor optocoupler
    [stoomshield1.sch]
2015-04-17 Software test: Added sensorgraph_test.
2015-04-17 Software test: Refactored sensorgraph_test into SensorGraph library. (prep for log/render of multiple sensors)
2015-04-17 Software test: Refactored sensorgraph_test (fix background render)
    [SensorGraph.cpp, SensorGraph.h, sensorgraph_test.ino]
2015-04-18 Software test: Refactored sensorgraph_test (custom color, render window)
2015-04-18 Software test: Now SensorGraph library can be used for multiple (seperate) graphs.
2015-04-20 Hardware test: eagle schema details
    [stoomshield1.sch]
2015-04-20 Hardware test: eagle pcb mockup backup
    [stoomshield1.brd]
2015-04-22 Hardware test: improved eagle pcb (100x80mm) with sensor leds.
    [stoomshield1.brd, stoomshield1.sch]
2015-04-24 Hardware test: improved eagle pcb screw contact wiring.
    [stoomshield1.brd, stoomshield1.sch]
2015-04-24 Hardware test: improved eagle pcb+schema for relay.
    [stoomshield1.brd, stoomshield1.sch]
2015-04-29 Hardware test: aproximated eagle pcb TFT connector placement.
    [stoomshield1.brd]
2015-06-02 Fix UTFT demo to work with prototype wiring.
    [UTFT_Demo_320x240_SSD1289.ino]
2015-06-06 Software test: Updated sensorgraph_test to new hardware setup (prototype 2)
2015-06-07 Hardware schema: Fixed RS pull-up.
    [stoomshield1.brd, stoomshield1.sch]
2015-06-12 Prototype2 hardware: Reorganizing files.
    [prototype2.brd, prototype2.sch]
2015-06-12 Prototype1 hardware: Reorganizing files.
    [kleppen.brd, kleppen.sch, sac_4klep.sch]
2015-06-12 Prototype1 software: Reorganizing files.
2015-06-12 Prototype2 software: Initial empty Arduino project.
2015-06-12 Prototype2 software: Added UTFT and test render.
2015-06-12 Prototype2 software: Now uses (quadratic encoder) sensors, shows state and keeps position.
2015-06-12 Prototype2 software: Now tracks errors + asserts.
2015-06-12 Prototype2 software: Now tracks errors + asserts for zero position.
2015-06-13 Prototype2 software: Now tracks FPS.
2015-06-13 Prototype2 software: Now calculates FPS/RPM as float. (performance hit: FPS dropped to 13 fom 20)
2015-06-13 Prototype2 software: Removed float FPS/RPM calculations. (performance gain: FPS from 13 to 14)
2015-06-13 Prototype2 software: Fixed RPM negative overflow, for now.
2015-06-15 Prototype2 software: Settings for sundays test.
2015-06-15 Prototype2: Added readme.
2015-06-20 Prototype2 software: Testing hardware/wiring change. (in preperation for reading port C)
2015-06-21 Resources: added datasheet of Arduino Due mcu.
2015-06-21 Prototype2 software: Testing reading port C.
2015-06-21 Prototype2 software: Testing portait display, for fitting graphs.
2015-06-22 Prototype2 software: Demonstrated upto 150000 measurements per second, changing from 1000 to 50000.
2015-07-05 Prototype2 software: Testing analogRead (late commit)
2015-07-05 Prototype2 software: Initial RevLog test. (tested, works)
2015-07-05 Prototype2 software: Added RPM to RevLog.
2015-07-05 Prototype2 software: Added margin values to RevLog.
2015-08-08 Prototype2 software: Added rowcolors to RevLog.
2015-08-08 Prototype2 software: Added interim valveAin valveAout outputs.
2015-08-08 Prototype2 software: Fixed valveAin valveAout output pins
2015-08-15 Prototype2 software: Initial test for logging valveAin valveAout output
2015-08-15 Prototype2 software: Better valve timing.
2015-08-15 Prototype2 software: Fixed logging valveAin valveAout output
2015-08-22 Prototype2 software: Complete logging valveAin valveAout output
2015-08-22 Prototype2 software: Test valve timing. (50% trim)
2015-08-22 Prototype2 software: Test valve timing. (25% trim)
2015-08-29 Prototype2 software: Test start prerequisites: zero-sensor.
2015-08-29 Prototype2 software: Test valve timing. (test door rik)
2015-09-02 Prototype2 software: Test valve timing. (input longer, less vacuum)
2015-09-03 Prototype2 software: Test valve timing. (output shorter)
2015-09-05 Aircontrol: Add green button test code
2015-09-11 Aircontrol: Fixed GRAPH screen.
    [RevLog.cpp, RevLog.h]
2015-09-11 Aircontrol: Made ReverseRPM and OverspeedRPM redflags sticky. Requires reboot.
    [Fouten.cpp]
2015-09-11 Aircontrol: Fixed motor ESTOP contacts.
    [Fouten.cpp]
2016-02-04 Toevoegen overdruk sensor. (compileert maar nog niet aangelsoten of getest)
2016-03-12 Aansluiten overdruk sensor. (nog niet getest)
2016-08-27 Aircontrol: New valve timing. (late commit, 2015-05-02)
2016-11-02 Aircontrol: Fixed Overdruk readout. (tested with John+Jo+Barry, working OK, sensor set to 7 bar)
    [Fouten.cpp]
2017-02-10 Documentatie update: pinout op Arduino Due sturing
2017-02-11 Testcode met omgedraaide valveAout start/stop en omgekeerde (normaly-open) relais contacten + omgekeerde overdruk sensor
2017-02-11 Testcode met (beter) omgedraaide valveAout start/stop (in plaats van 0)
2018-02-10 Nette versie 2017, revisie 1, schemas
    [Aansluitlijst aircontroller 2017.xlsx, Kabelschema aircontroller 2017.xlsx, Schema aircontroller 2015.xlsx, Verloopkabel display.xlsx]
2018-02-10 Nette versie 2017, revisie 1, software (kopie van eclipse project \Prototype2\software\eclipse\stoomshield_prototype2\ )
2018-02-10 Nette versie 2017, revisie 3, software: 2017-06-15 John - werkende encoders
2022-05-21 Workaround toegevoegd om Zero-Sensor Errors te resetten terwijl de machine draait.
    [aircontrol.ino]
